Abdullahr29/ElectronicStethoscopeOrCAD/ARehmanSPICELabs-PSpiceFiles/SCHEMATIC5/ex5/ex5.cir

** Profile: "SCHEMATIC5-ex5"  [ H:\Documents\Labs\arehmanspicelabs-pspicefiles\schematic5\ex5.sim ] 

** Creating circuit file "ex5.cir" 
** WARNING: THIS AUTOMATICALLY GENERATED FILE MAY BE OVERWRITTEN BY SUBSEQUENT SIMULATIONS

*Libraries: 
* Profile Libraries :
* Local Libraries :
* From [PSPICE NETLIST] section of H:\cdssetup\OrCAD_PSpice/16.6.0/PSpice.ini file:
.lib "nom.lib" 

*Analysis directives: 
.TRAN  0 20ms 0 
.OPTIONS ADVCONV
.PROBE64 V(alias(*)) I(alias(*)) W(alias(*)) D(alias(*)) NOISE(alias(*)) 
.INC "..\SCHEMATIC5.net" 


.END
