Abdullahr29/ElectronicStethoscopeOrCAD/ARehmanSPICELabs-PSpiceFiles/SCHEMATIC6/ex6/ex6.cir

** Profile: "SCHEMATIC6-ex6"  [ H:\Documents\Labs\arehmanspicelabs-pspicefiles\schematic6\ex6.sim ] 

** Creating circuit file "ex6.cir" 
** WARNING: THIS AUTOMATICALLY GENERATED FILE MAY BE OVERWRITTEN BY SUBSEQUENT SIMULATIONS

*Libraries: 
* Profile Libraries :
* Local Libraries :
* From [PSPICE NETLIST] section of H:\cdssetup\OrCAD_PSpice/16.6.0/PSpice.ini file:
.lib "nom.lib" 

*Analysis directives: 
.TRAN  0 8m 0 
.OPTIONS ADVCONV
.PROBE64 V(alias(*)) I(alias(*)) W(alias(*)) D(alias(*)) NOISE(alias(*)) 
.INC "..\SCHEMATIC6.net" 


.END
