Abdullahr29/ElectronicStethoscopeOrCAD/ARehmanSPICELabs-PSpiceFiles/SCHEMATIC7/ex7/ex7.cir

** Profile: "SCHEMATIC7-ex7"  [ H:\Documents\Labs\ARehmanSPICELabs-PSpiceFiles\SCHEMATIC7\ex7.sim ] 

** Creating circuit file "ex7.cir" 
** WARNING: THIS AUTOMATICALLY GENERATED FILE MAY BE OVERWRITTEN BY SUBSEQUENT SIMULATIONS

*Libraries: 
* Profile Libraries :
* Local Libraries :
* From [PSPICE NETLIST] section of H:\cdssetup\OrCAD_PSpice/16.6.0/PSpice.ini file:
.lib "nom.lib" 

*Analysis directives: 
.AC DEC 10 10 10k
.OPTIONS ADVCONV
.PROBE64 V(alias(*)) I(alias(*)) W(alias(*)) D(alias(*)) NOISE(alias(*)) 
.INC "..\SCHEMATIC7.net" 


.END
