Abdullahr29/ElectronicStethoscopeOrCAD/(list of files, drawings)

Other design files:
AREHMANSPICELABS.DSN
ARehmanSPICELabs.opj
